Jdjdjdjdj17/Equipo-6/Pendulo/conexiones/00_conexion_completa.png

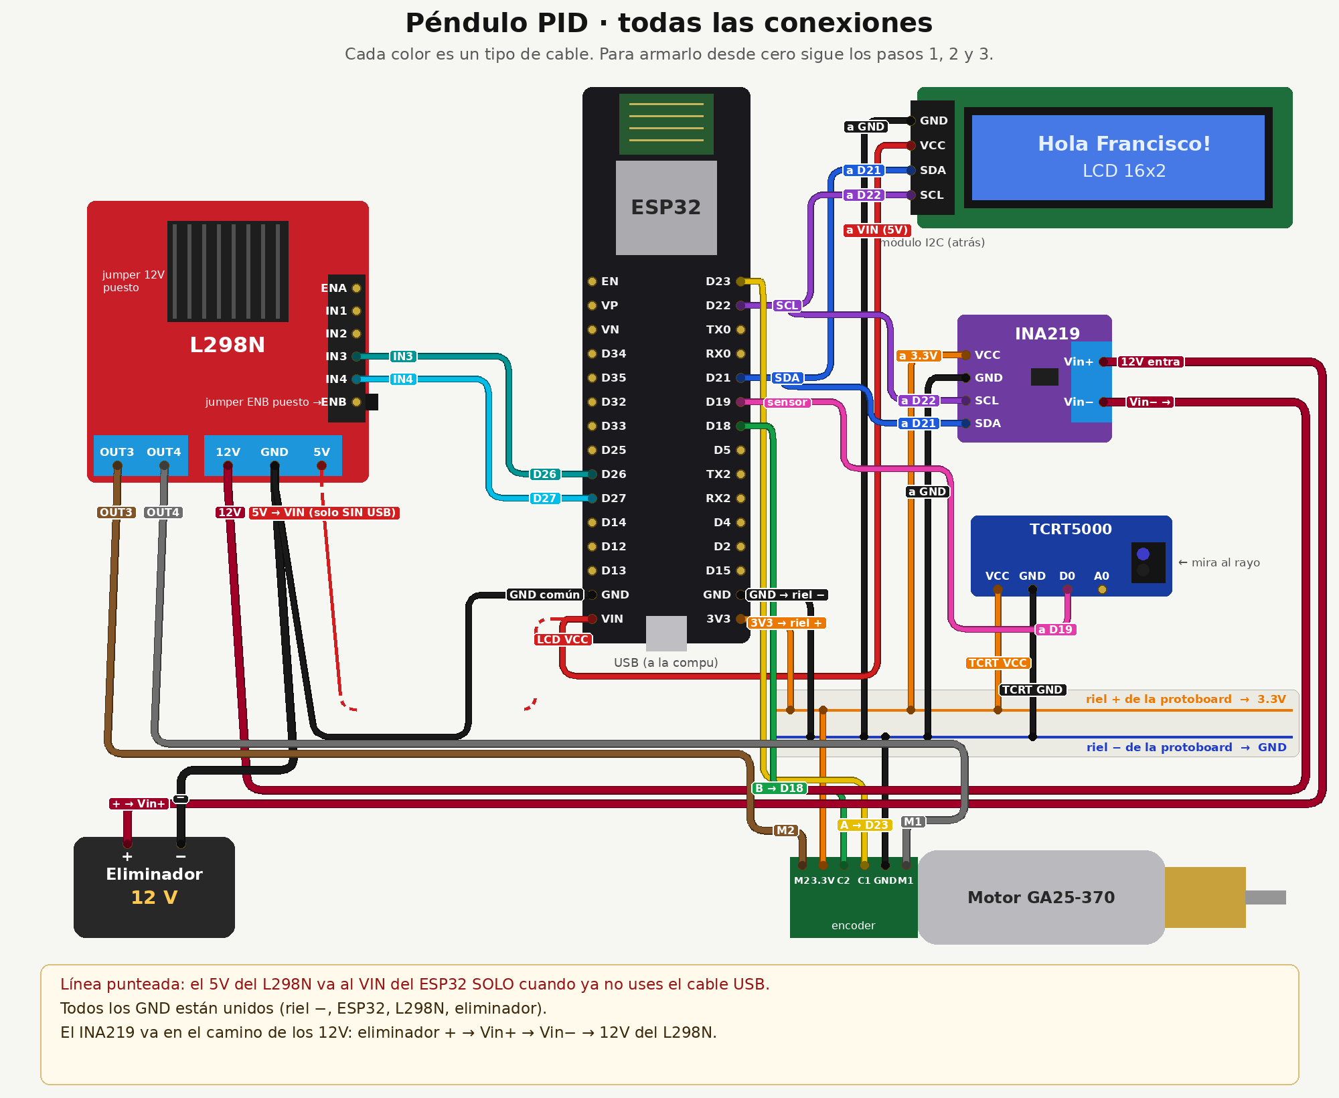
Pendulo/conexiones/00_conexion_completa.png
