Jdjdjdjdj17/Equipo-6/Pendulo/conexiones/01_ficha_ESP32.png

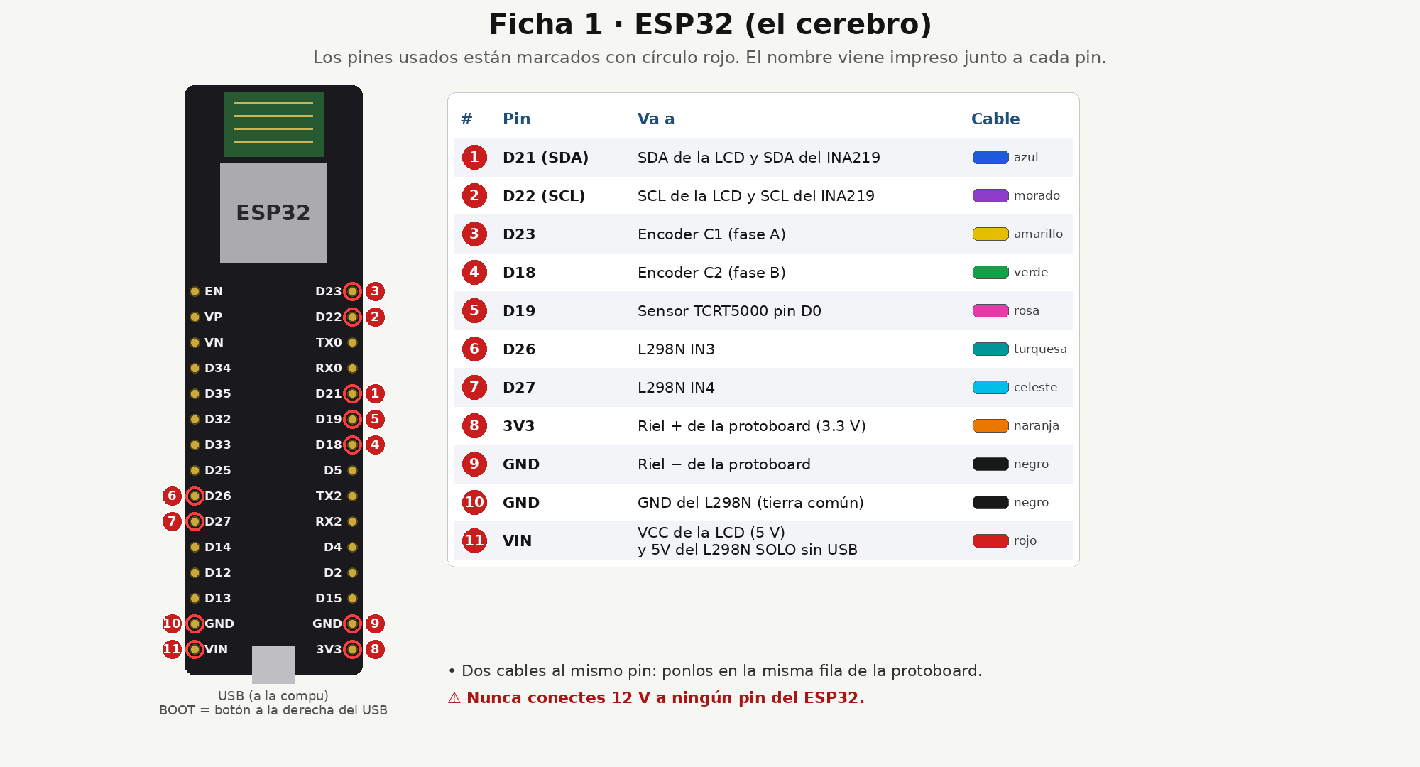
Pendulo/conexiones/01_ficha_ESP32.png
