Jdjdjdjdj17/Equipo-6/Pendulo/conexiones/02_ficha_L298N.png

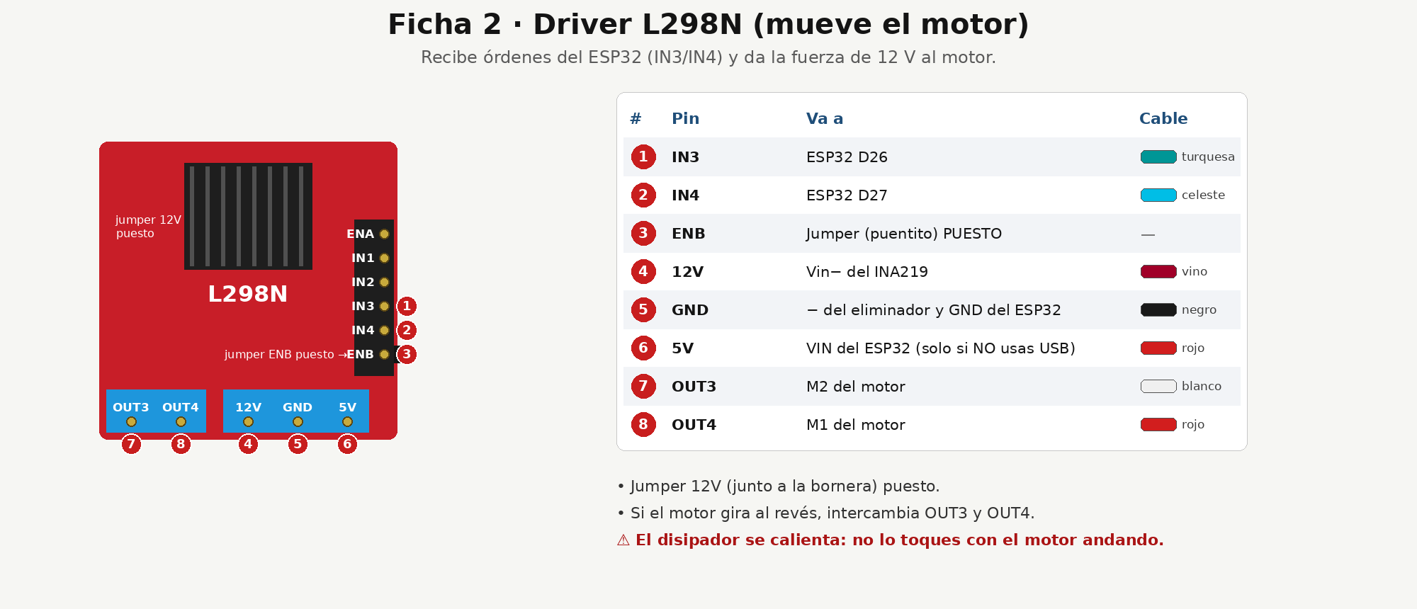
Pendulo/conexiones/02_ficha_L298N.png
