Jdjdjdjdj17/Equipo-6/Pendulo/conexiones/03_ficha_INA219.png

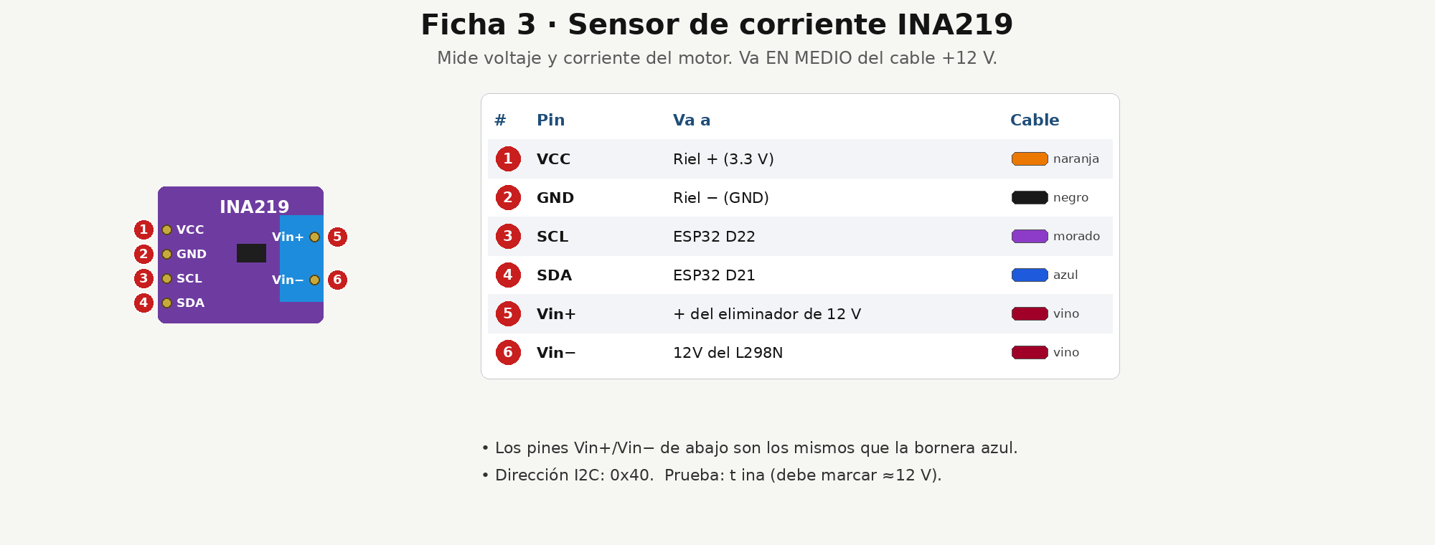
Pendulo/conexiones/03_ficha_INA219.png
