Jdjdjdjdj17/Equipo-6/Pendulo/conexiones/04_ficha_LCD.png

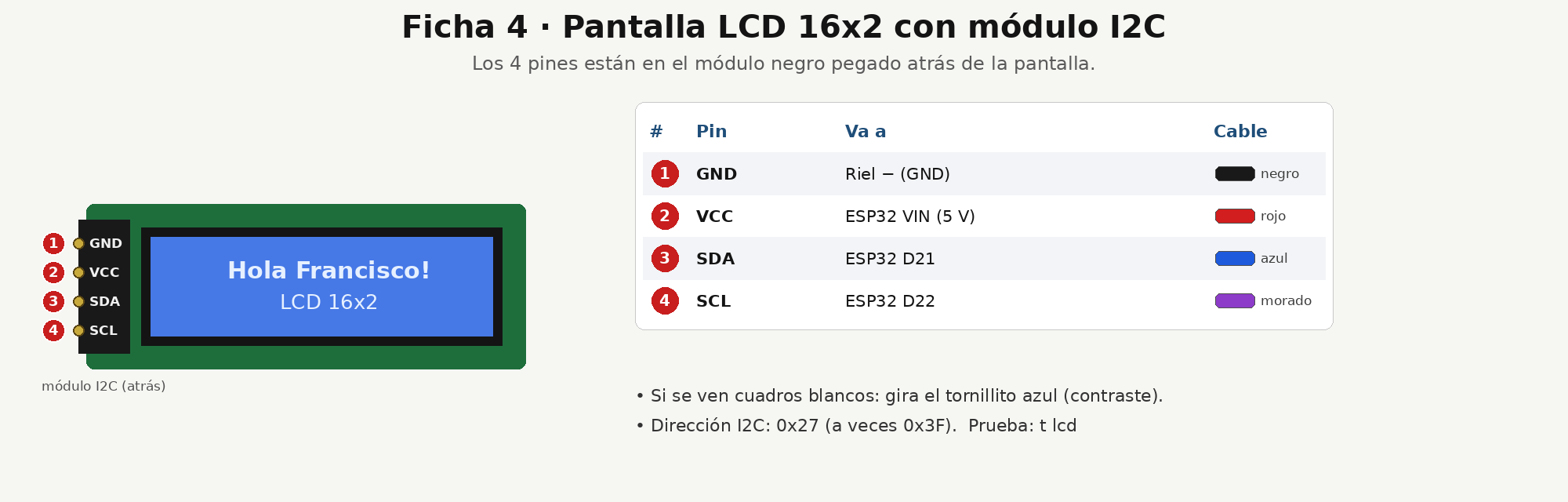
Pendulo/conexiones/04_ficha_LCD.png
