Jdjdjdjdj17/Equipo-6/Pendulo/conexiones/05_ficha_TCRT5000.png

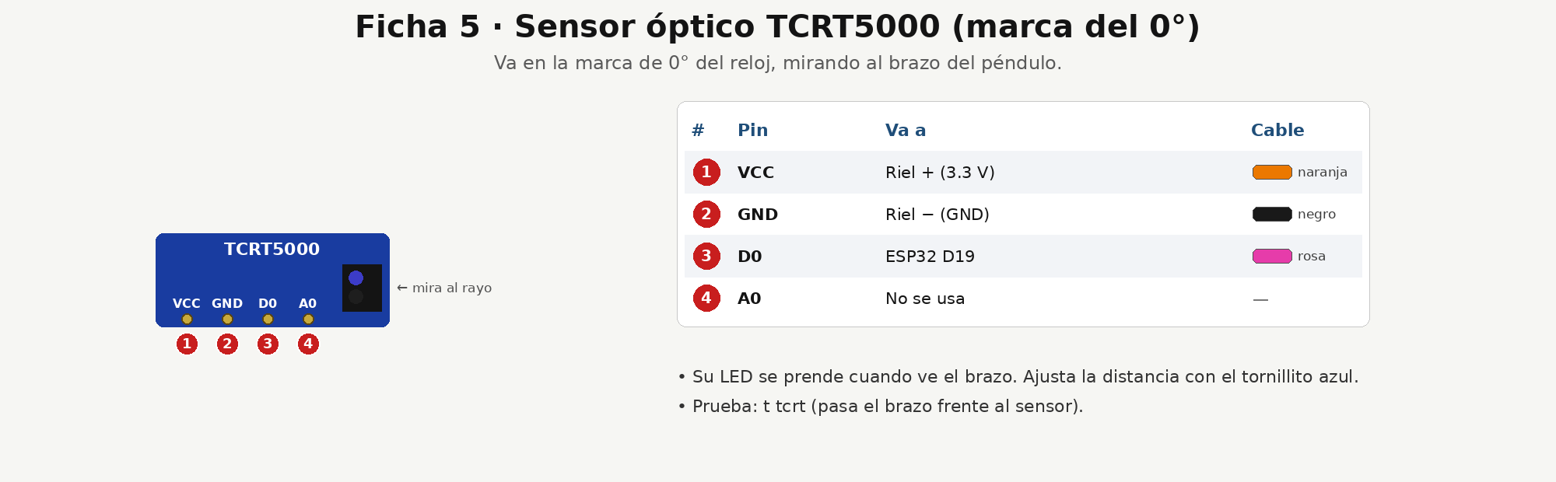
Pendulo/conexiones/05_ficha_TCRT5000.png
