Jdjdjdjdj17/Equipo-6/Pendulo/conexiones/06_ficha_motor_encoder.png

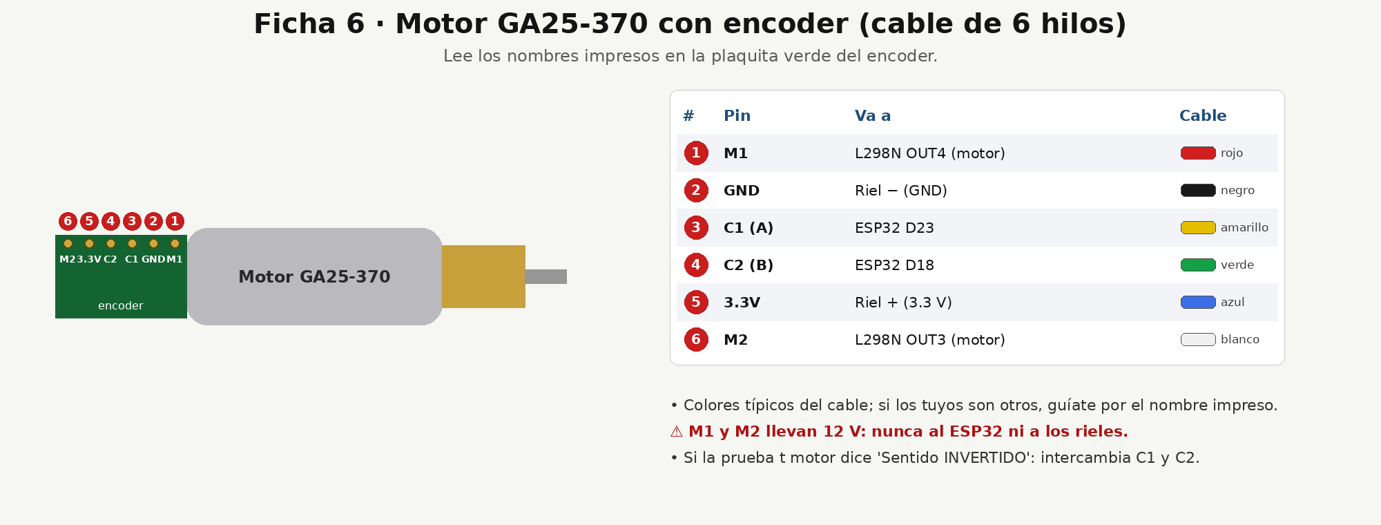
Pendulo/conexiones/06_ficha_motor_encoder.png
