Jdjdjdjdj17/Equipo-6/Pendulo/conexiones/07_ficha_eliminador_12V.png

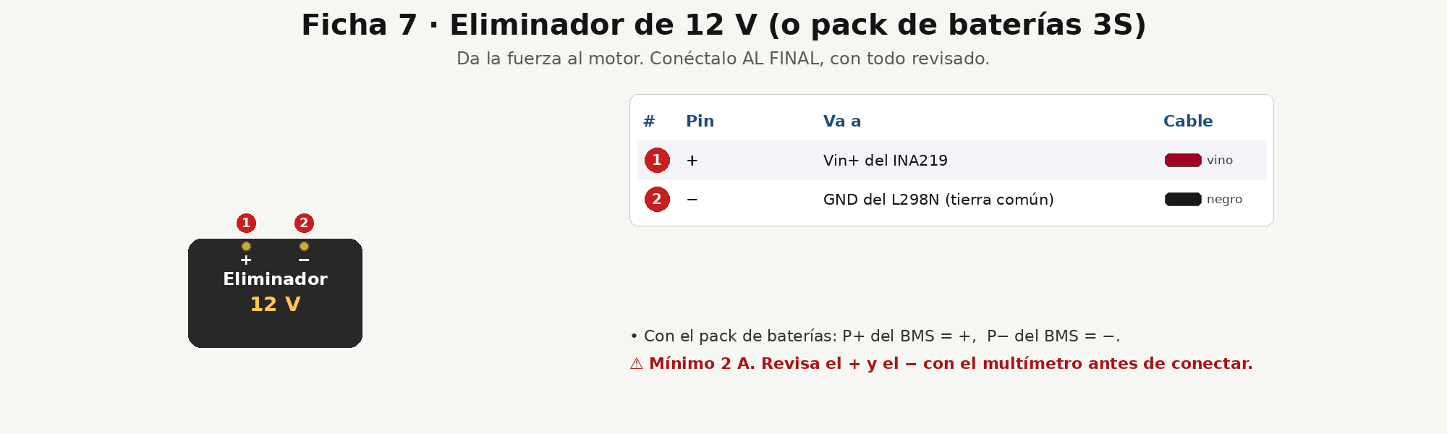
Pendulo/conexiones/07_ficha_eliminador_12V.png
