Jdjdjdjdj17/Equipo-6/Pendulo/conexiones/paso1_lcd_ina219.png

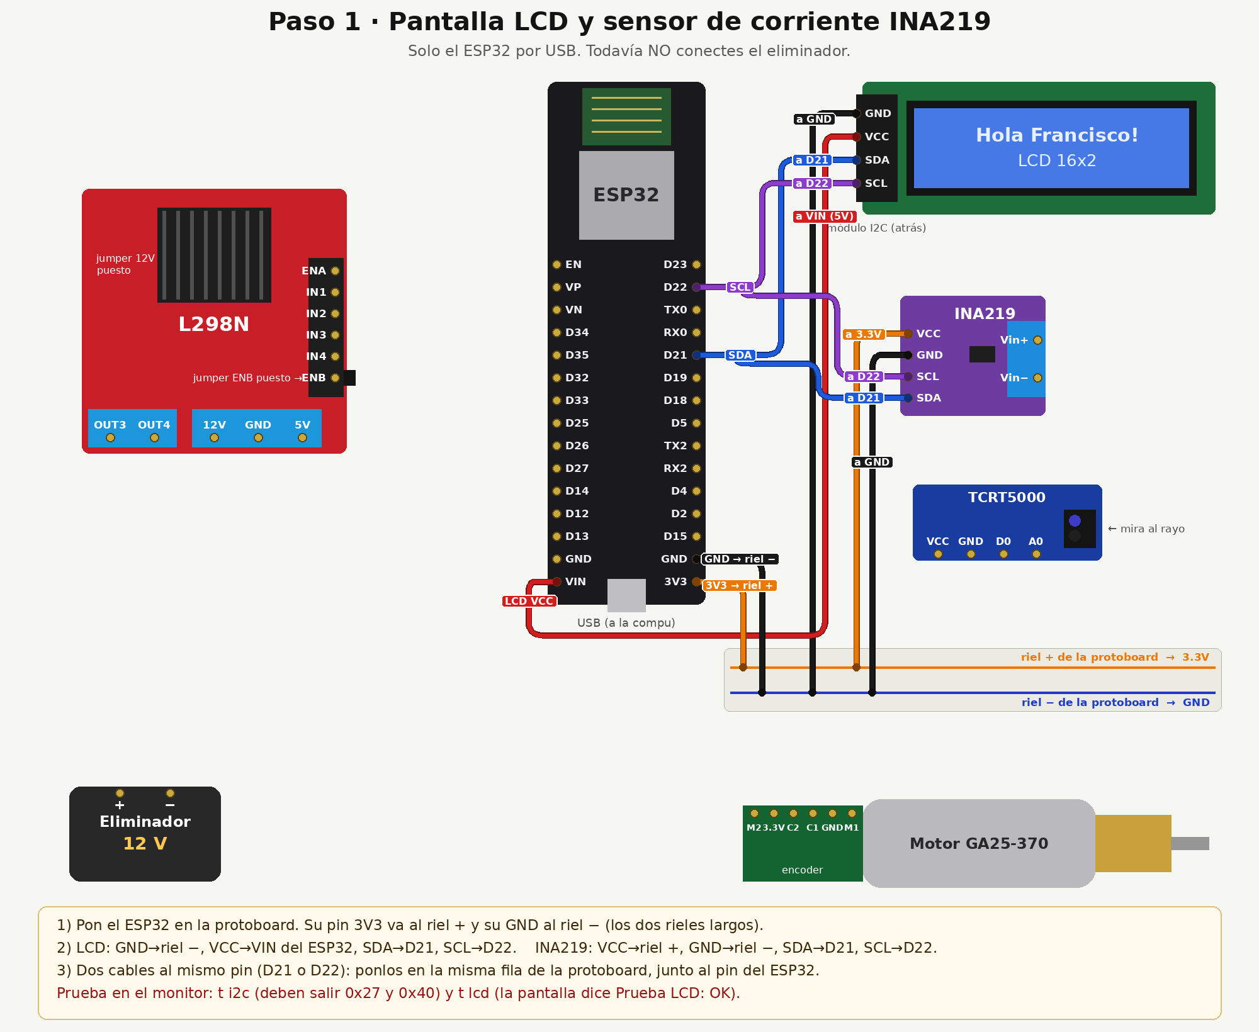
Pendulo/conexiones/paso1_lcd_ina219.png
