Jdjdjdjdj17/Equipo-6/Pendulo/conexiones/paso2_encoder_tcrt.png

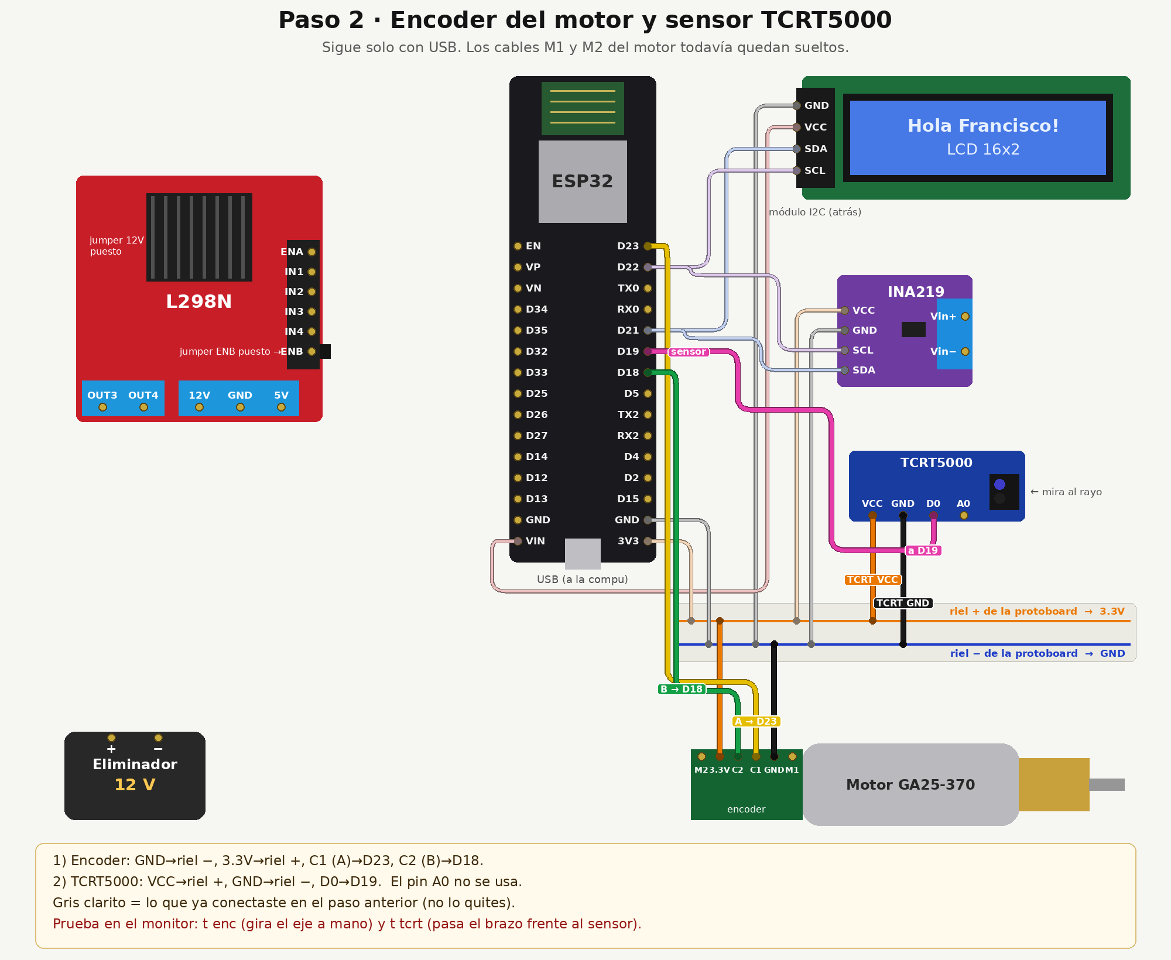
Pendulo/conexiones/paso2_encoder_tcrt.png
