Jdjdjdjdj17/Equipo-6/Pendulo/conexiones/paso3_motor_driver_12V.png

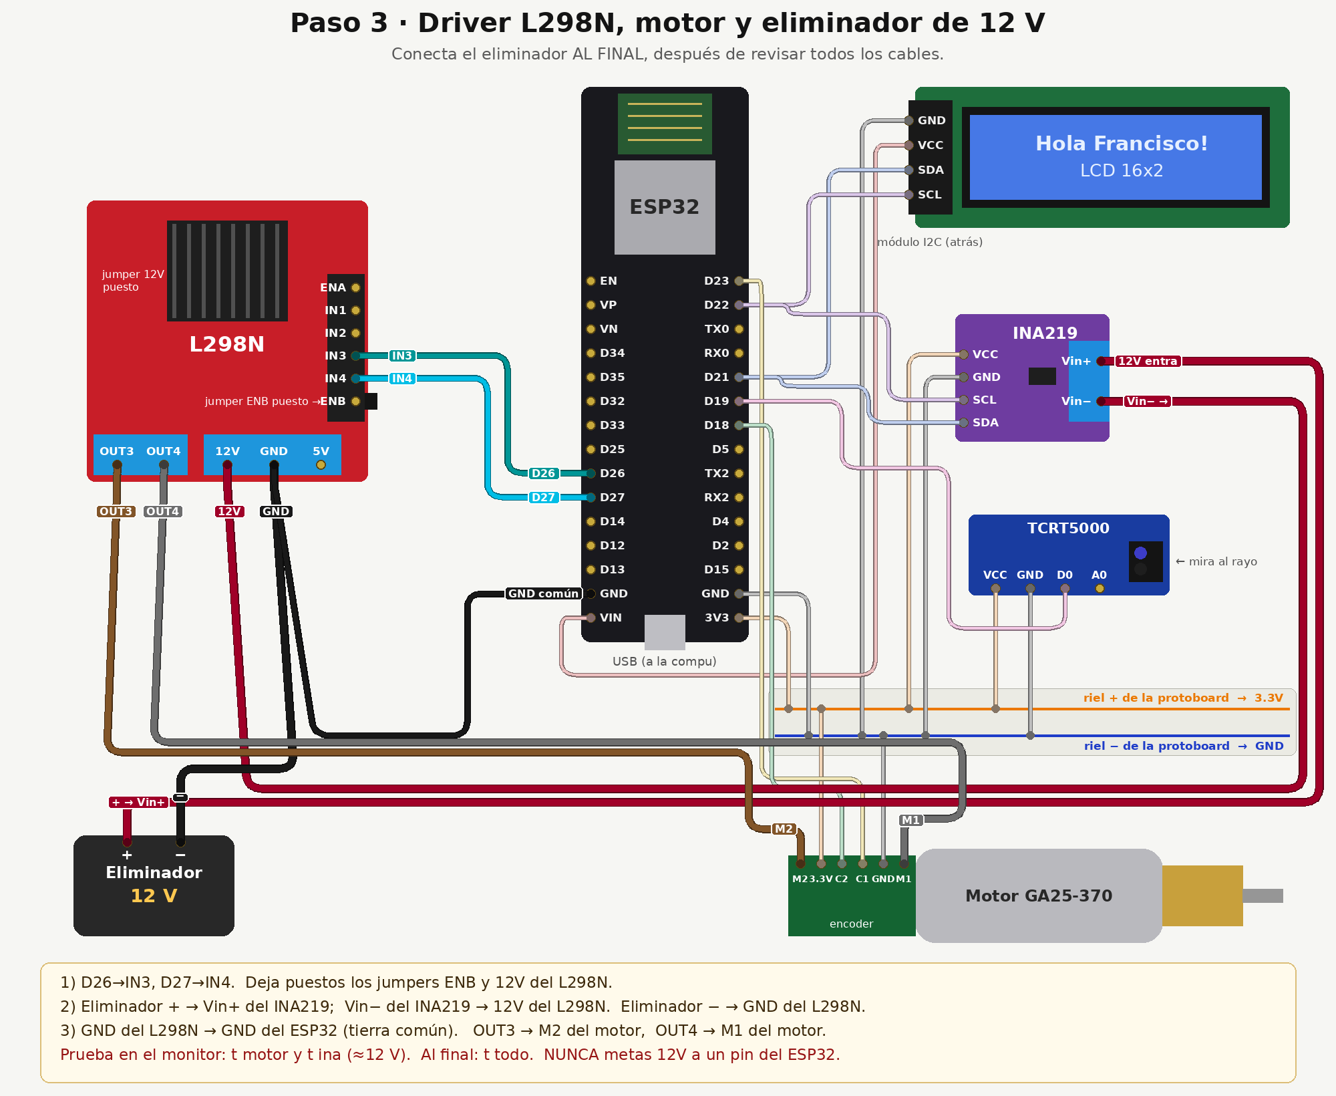
Pendulo/conexiones/paso3_motor_driver_12V.png
